dtwprojects/rocket_sao_badge/pcb/sao_light_coms.csv

Reference | Value | Datasheet | Footprint | Qty | DNP
A1 | ALS-PT19-315C_L177_TR8 |  | ALS_PT19_315C_L177_TR8:XDCR_ALS-PT19-315C_L177_TR8 | 1 |  | 35 | $8.37
C1 | 10u | ~ | Capacitor_SMD:C_0603_1608Metric_Pad1.08x0.95mm_HandSolder | 1 |  |  | -
C2 | C | ~ | Capacitor_SMD:C_0603_1608Metric_Pad1.08x0.95mm_HandSolder | 1 | DNP |  | -
C3 | 0.1u | ~ | Capacitor_SMD:C_0603_1608Metric_Pad1.08x0.95mm_HandSolder | 1 | DNP |  | -
D1,D4,D5,D6,D7 | LED | ~ | LED_SMD:LED_0603_1608Metric_Pad1.05x0.95mm_HandSolder | 5 |  |  | -
D2,D3,D8,D9,D10,D11 | LED | ~ | LED_THT:LED_D3.0mm | 6 | DNP
J1 | Conn_01x05 | ~ | Connector_JST:JST_PH_S5B-PH-K_1x05_P2.00mm_Horizontal | 1 |  |  | /
J3 | Conn_02x03_Odd_Even | ~ | Simple_Addon_v2:Simple_Addon_v2-SAO-2x3 | 1 |  | - | - | Bought
Q1 | BC818 | https://www.onsemi.com/pub/Collateral/BC818-D.pdf | Package_TO_SOT_SMD:SOT-23 | 1 |  | 35 | $10.43
R1 | 56k | ~ | Resistor_SMD:R_0603_1608Metric_Pad0.98x0.95mm_HandSolder | 1 |  |  | -
R2 | 0 | ~ | Resistor_SMD:R_0603_1608Metric_Pad0.98x0.95mm_HandSolder | 1 |  |  | -
R3 | 0 | ~ | Resistor_SMD:R_0603_1608Metric_Pad0.98x0.95mm_HandSolder | 1 | DNP |  | -
R4,R5 | 110k | ~ | Resistor_SMD:R_0603_1608Metric_Pad0.98x0.95mm_HandSolder | 2 | DNP |  | -
R6 | 100 | ~ | Resistor_SMD:R_0603_1608Metric_Pad0.98x0.95mm_HandSolder | 1 | DNP |  | -
R7,R8 | 4.7k | ~ | Resistor_SMD:R_0603_1608Metric_Pad0.98x0.95mm_HandSolder | 2 | DNP |  | -
R9 | R_US | ~ | Resistor_SMD:R_0603_1608Metric_Pad0.98x0.95mm_HandSolder | 1 |  |  | -
R10 | 1k | ~ | Resistor_SMD:R_0603_1608Metric_Pad0.98x0.95mm_HandSolder | 1 | DNP |  | -
SW1 | SW_Push_Dual | ~ | Button_Switch_THT:SW_PUSH_6mm_H4.3mm | 1 | DNP
U1 | ATtiny85-20S | http://ww1.microchip.com/downloads/en/DeviceDoc/atmel-2586-avr-8-bit-microcontroller-attiny25-attiny45-attiny85_datasheet.pdf | Package_SO:SOIC-8W_5.3x5.3mm_P1.27mm | 1 |  |  | -
U2 | LM358A-SR | LM358A-SR | footprints:SOP8_TPK | 1 | DNP |  | $-
U3 | LP5810ADSDR | https://www.ti.com/lit/gpn/lp5810 | footprints:DSD0008B-IPC_A | 1 |  | 35 | $18.96
 |  |  |  |  |  | 0
 |  |  |  |  |  | 56k
 |  |  |  |  |  | 1k
 |  |  |  |  |  | 4.7k
 |  |  |  |  |  | 220
 |  |  |  |  |  | 464
 |  |  |  |  |  | 110k
 |  |  |  |  |  | 22k
 |  |  |  |  |  | 47
 |  |  |  |  |  | 22
