dtwprojects/rocket_sao_badge/(commit log)

2026-09-23 Initial commit and adding pcb
    [sao_light_coms.csv, sao_light_coms.kicad_pcb, sao_light_coms.kicad_sch]
2026-11-07 Add Billboard badge link for the rocket SAO
    Add a badge driver and app that control the LP5810 directly over the SAO
    bus: LED control, autonomous animations, and ambient light readings.
    Add rocket_fw, which releases the USI after setup. With TinyWireM's
    two-wire mode left active, the first START from the badge made the start
    detector hold SCL low and froze the bus until a power cycle.
2026-11-07 Add rocket ATtiny smart peripheral and badge-side flashing
    rocket_fw runs as an I2C target at 0x2A. It exposes light level, a Q1 LED
    PWM, EEPROM storage and a jump into twiboot. If no host shows up within
    about 5 s, it starts an animation on its own.
    The badge can update the ATtiny over the SAO I2C bus with twiboot at 0x29.
    The patched twiboot (rocket.patch) and its prebuilt hex are included.
    rocket_sao.py gains ATtiny register access.
    Tested on hardware: a v1 to v2 to v1 update cycle passed, 183k mixed
    transfers ran with no errors, and EEPROM survived reflashes.
    [rocket_fw.ino]
